krosa-laboratory/analog-pid-buck-controller/Docs/DOC-ANALOG-004.pdf

## DOC-ANALOG-004

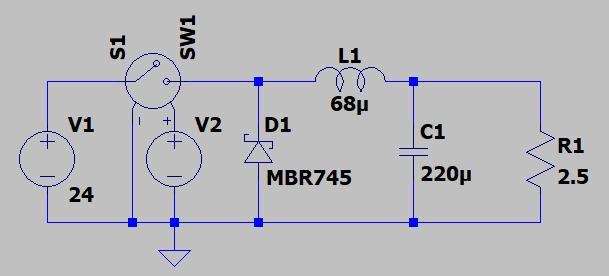
[picture p1: figure]

1 Analysis of the Initial Transient and Settling Time Constant

The observation of current behavior during the first 4–5 ms is a major physical finding that directly validates the quality factor derived in DOC-ANALOG-002.

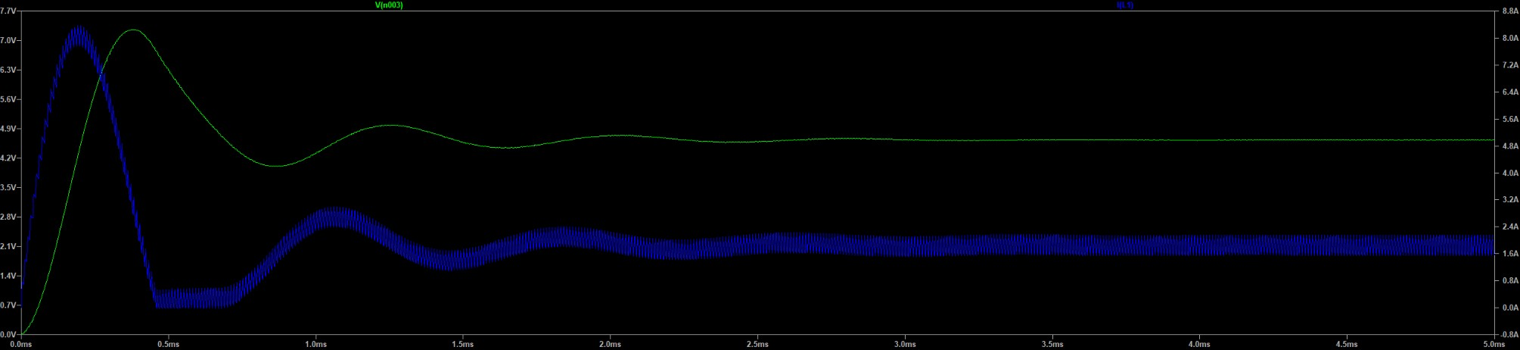
[picture p2: figure]

Figure 1: Vout & IL behavior during initial ms.

The damped sinusoidal envelope observed before reaching steady state is due to the natural response of the underdamped second-order system. The frequency of this transient oscillation corresponds to the damped resonant frequency of the LC filter:

The system's damping time constant (τplant) is determined by the damping coefficient ζ and the natural frequency ω0:

For the transient envelope to decay to 99% of its steady-state value, the system mathematically requires a settling time (ts):

This explains with absolute precision why the current in the coil does not stabilize cleanly until it has passed the 4–5 ms threshold.

2 Quantitative Comparison: Theory vs. Stepped Transient Simulation

Dynamic/Physical Parameter | Theoretical Value (DOC-ANALOG-001) | Actual Measurement in LTspice | Deviation / Error | Technical Conclusion
Peak Current | 2.291 A | 2.150 A | -6.15 % | Lower peak current due to the lower DC output voltage.
Valley Current | 1.709 A | 1.559 A | -8.78 % | Operation fully confirmed in Continuous Driving Mode.
Current Ripple | 0.582 Ap-p | 0.590 Ap-p | +1.37 % | Excellent match. The actual inductive oscillation meets the nominal design specifications.
Output Ripple | ≤ 20.000 mVp-p | 14.739 mVp-p | -26.31 % | It meets the requirement. The 25 mΩ ESR keeps the capacitive noise at 14.74 mV.
Avg. Output Voltage | 5.000 V (Ideal O.Loop) | 4.634 V | -7.32 % | Static voltage drop due to nonlinear losses in the diode.

3 Physical Explanation of the DC Voltage Drop (4.6343 V vs. 5.0000 V)

The measured value of Vout_avg = 4.6343 V, rather than the ideal 5.0000 V, reveals the crucial difference between an ideal model on paper and the physics of a nonlinear switched circuit:

During each switching period Tsw = 10 μs:

- Interval ton = D · Tsw ≈ 2.083 μs (20.83% of the time): The upper switch, S1, is on. Current flows through RDS.on = 10 mΩ and the coil's DCR (rL = 25 mΩ).
- Interval toff = (1 – D) · Tsw ≈ 7.917 μs (79.17% of the time): Switch S1 opens. The current through the coil forces the MBR745 Schottky diode into forward conduction.

The Schottky diode introduces a forward voltage drop Vf ≈ 0.45 V to 0.50 V during nearly 80% of each cycle.

The nominal average voltage at the switching node SW in steady state is given by:

Substituting the circuit values:

Subtracting the additional attenuation caused by the divider consisting of the DCR (rL = 25 mΩ) and the load (RL = 2.5 Ω):

Demonstration of the Need for a Closed-Loop Analog System

This calculation shows that, in open-loop operation, nonlinear drops in semiconductors and parasitic elements degrade static regulation by -7.32%.

This is the purpose of our project: The analog compensator based on op-amps will continuously measure the output voltage Vout, compare it to the stable 5,000 V reference, and dynamically adjust the duty cycle D until the deviation is corrected to exactly 0.000 V of error in steady state.

4 Formal Completion of current Milestone

With the validation of the dynamic signature in small signals (DOC-ANALOG-003) and the confirmation of transient and ripple waveforms in the time domain (DOC-ANALOG-004), the current milestone is officially completed and successfully closed.

5 Start of the Next Milestone: Synthesis of the Type II Compensator

We are now moving on to the design phase of the closed-loop analog controller.

Parámetros de Diseño Fijados para el Compensador Tipo II

- Target Crossing Frequency (fC): 10.0 kHz
- Required Op-Amp Gain at 10 kHz (Av.fc): +7.34 dB
- Required Phase Increase (ϕboost): +48.53º (at 10 kHz)
- Input Resistance (RL): 10.0 kΩ (0.1% tolerance)

Synthesis Equations for the Type II Compensator

To inject the phase boost ϕboost centered exactly at fc = 10.0 kHz, the zero fz1 and the pole fp1 of the op-amp's R-C network must be placed symmetrically around fc:

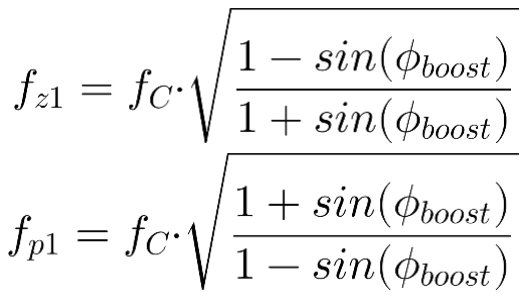
[picture p3: figure]

Substituting phi_boost = 48.53° (sin(48.53°) ≈ 0.7493):

1. Compensator Zero Location: fz1 = 10,000 · 0.3785 ≈ 3.785 kHz
2. Location of the High-Frequency Complex: fp1 = 10,000 / 0.3785 ≈ 26.420 kHz

Equations for Passive Components (R2, C1, C2) With R1 = 10.0 kΩ

1. Calculation of R2:

Since fc is the geometric mean of fz1 and fp1, the root factor simplifies to unity at the crossover frequency:

2. Calculation of C1 (Zero Capacitor):
3. Calculation of C2 (High-Frequency Pole Capacitor):

Selection of Standard Marketable Securities (E96 / E24 at 1% and 5%)

- R1 = 10.0 kΩ (0.1% Metal Film)
- R2 = 23.2 kΩ (0.1% Metal Film)
- C1 = 1.80 nF (Polypropylene Film / C0G)
- C2 = 300 pF (C0G/NP0 Ceramic)

### 6 Summary and Final Selection of the Compensation Network (Type III)

### 6.1 Rationale for Architectural Migration

The small-signal simulation of the open-loop system (LC filter with L=68 uH, C=220 uF, DCR=25 mΩ, ESR=25 mΩ) revealed a critical phase delay in the plant of -158.53° at the target crossover frequency fc = 10 kHz. Combined with the -90° phase delay of the analog integrator at the input, the uncompensated phase drops to -248.53°.

A Type II compensator (limited to a phase shift of less than +60°) is physically incapable of stabilizing the system (resulting in an unstable phase margin of Φm = -21.09°). Consequently, a Type III compensator (2 zeros, 2 poles, and 1 integrator at the origin) is synthesized based on the ADA4610-1 ultra-low bias current JFET op-amp.

### 6.2 Impedance Architecture and Connection Diagram

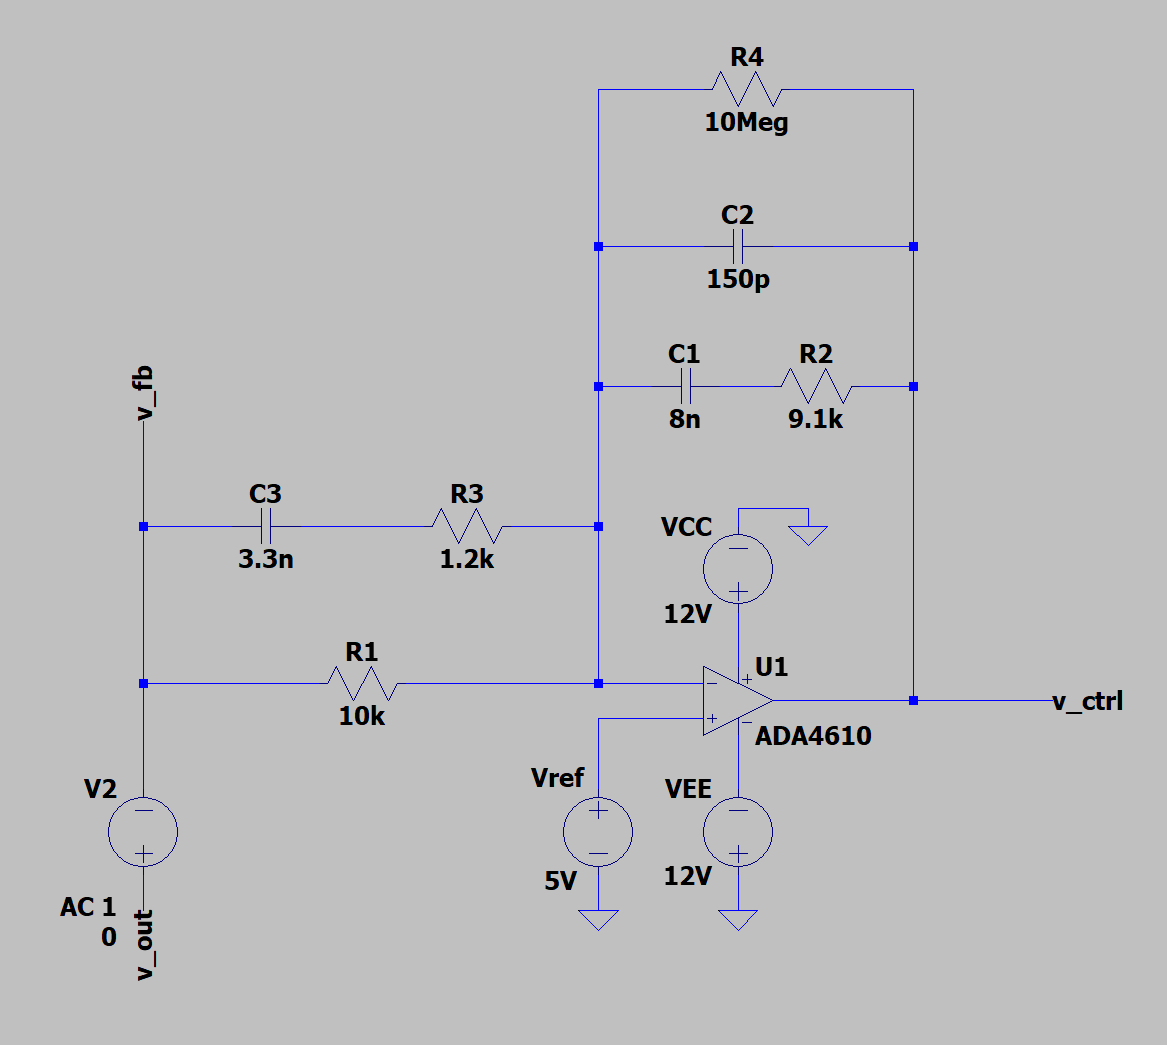
[picture p4: figure]

### 6.3 Complete Transfer Equation Av(s)

The complete transfer function of the Type III compensator is given by:

### 6.4 Physical Location of Zeros and Poles (Frozen BOM Values)

With the list of discrete components adjusted and validated in Ltspice:

- First Zero (fz1): Cancels the voltage drop across the LC dual pole of the power filter.
- Second Zero (fz2): It injects the pre-crossover phase shift.
- First Pole (fp1): Filters high-frequency noise and harmonics from the PWM modulator.

- Second Pole (fp2): Reduces switching noise without compromising phase at 10 kHz.

### 6.5 Frozen Bill of Materials (BOM) — Offset Network

- R1: 10.0 kΩ (0.1% tolerance, metal film, ±25 ppm/°C)
- R2: 9.10 kΩ (0.1% tolerance, metal film, ±25 ppm/°C)
- R3: 1.20 kΩ (0.1% tolerance, metal film, ±25 ppm/°C)
- C1: 8.00 nF (1% tolerancia, Película de Polipropileno / C0G)
- C2: 150.0 pF (1% tolerancia, Cerámico C0G/NP0)
- C3: 3.30 nF (1% tolerance, C0G/NP0 ceramic)
- Rdc: 10.0 MΩ (DC bias in parallel with Zf for SPICE stability)
