krosa-laboratory/analog-pid-buck-controller/Docs/DOC-ANALOG-006.pdf

## DOC-ANALOG-006

### 1 Objective and Evaluation Methodology

### 1.1 Main Objective

To document, characterize, and formally validate the closed-loop transfer function T(s) and the large-signal transient dynamic behavior of the analog control computer for the 10W synchronous Buck regulator (24V to 5V). The ultimate goal is to certify unconditional stability and operational reliability under demanding standards for high-precision industrial/military electronics.

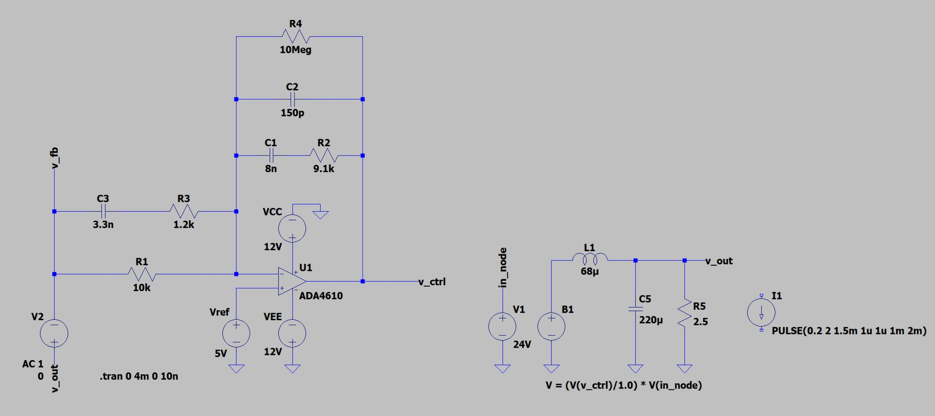
[picture p5: figure]

### 1.2 Small-Signal Injection Methodology (Middlebrook Method)

The gain and phase of the T(s) loop are extracted without disrupting the SPICE static continuous-current (DC) operating point. To do this:

1. An independent AC voltage source (Vtest = 1 V AC) is connected to the feedback node, between the output of the power filter (vout) and the compensator's input divider/network (vfb).
2. The complex stresses relative to mass at both ends are evaluated.
3. The open-loop transfer function evaluated in closed-loop is defined rigorously as the quotient of the phasors in the frequency domain:

### 1.3 Simulation Environment and Guidelines

- Frequency Simulation (.ac): Logarithmic sweep by decades (.ac dec 100 10 1Meg).
- Temporal Simulation (.trans): Transient analysis with a maximum integration step limited to 10 ns (.trans 0 4m 0 10n) to avoid numerical truncation errors during 100 kHz switching.

### 2 Closed-Loop Analysis in the T(s) Domain - Frequency Domain (.ac)

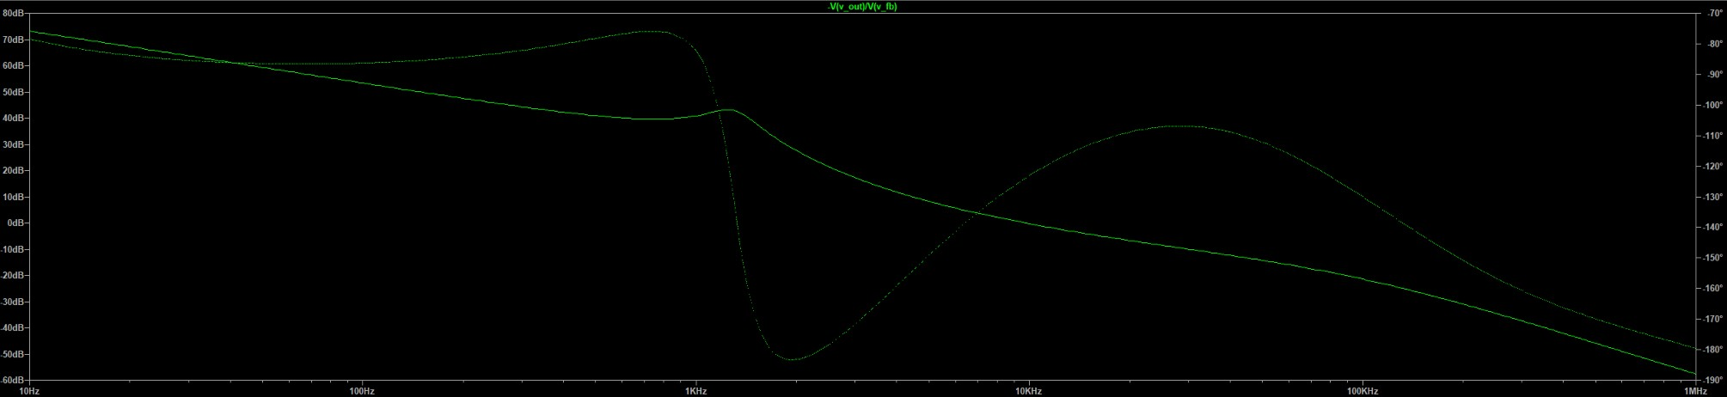
[picture p6: figure]

### 2.1 Stability Metrics Extracted in Ltspice

Subject to a small-signal injection Vtest = 1 V AC between v_out and v_fb:

Control Parameter | Measured Value | Design Criteria | Status
Crossover Frequency (fc) | 9.76 kHz | fc ≈ fsw / 10 (10 kHz) | Satisfied
Phase at fc | -123.81º | N/A | Satisfied
Phase Margin (Φm) | +56.19º | ≥ +45.0° (Desired 60°) | Optimal
Profit Margin (Am) | 33.65 dB | ≥ +10.0 dB | Strongly Satisfied

### 2.2 Mathematical Rigor and Stability Analysis

The phase margin is calculated analytically as:

A phase margin of +56.19° corresponds to a damping factor in the Laplace domain of:

Physically, this value of ζ perfectly balances the response speed against the overshoot, ensuring an optimally damped transient response without sustained oscillations or the risk of phase divergence.

The gain margin of 33.65 dB (measured at the frequency where T(s) = -180°) implies that the loop ∠ gain would have to be multiplied by a factor greater than 48 for the system to become unstable. This provides extraordinary tolerance to component deviations due to aging, variations in thermal tolerances of passive components (R, L, C), and sudden drops or spikes in the 24 V primary bus voltage.

### 3 Large-Signal Dynamic Response - Time Domain (.trans)

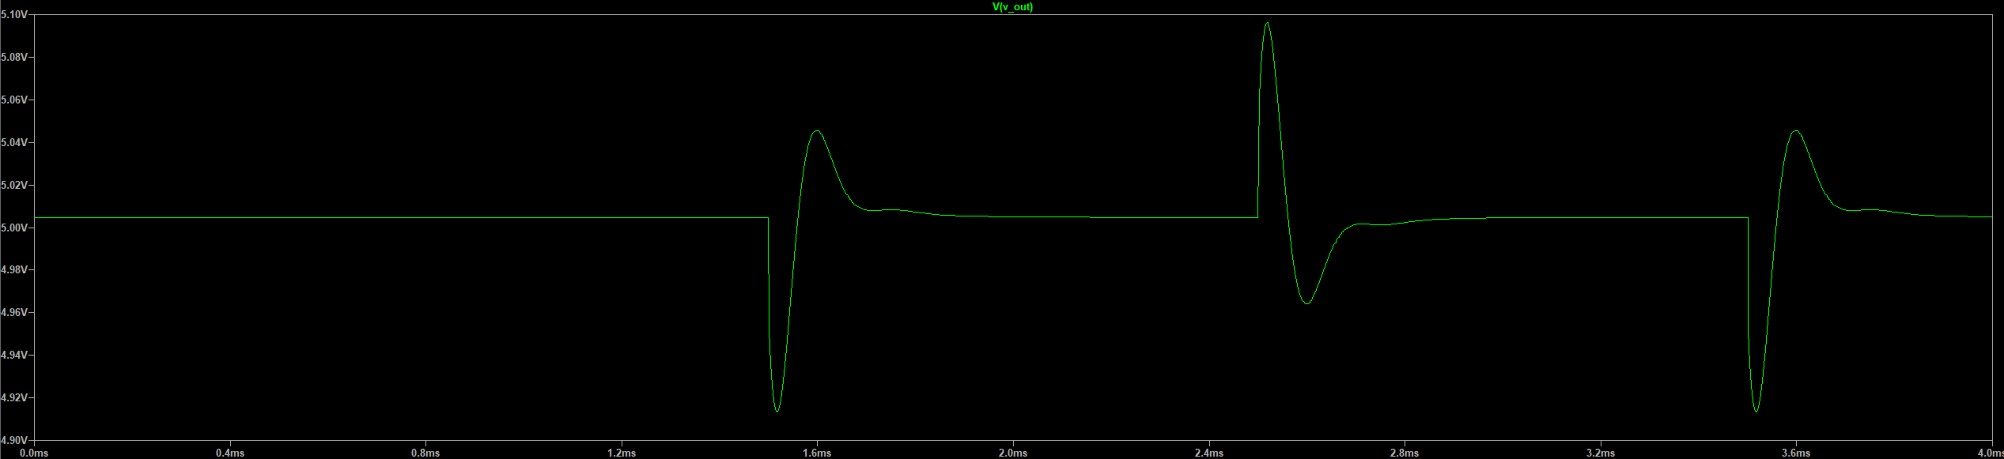
[picture p7: figure]

### 3.1 Load Transient Boundary Condition

Evaluation in the event of a step-type current disturbance at the output Iout:

- Initial quiescent current: I1 = 0.2 A (10% of the rated load).
- Full-load step: I2 = 2.0 A (100% of the rated load, ΔI = 1.8 A).
- Rise/fall time: trise = tfall = 1.0 μs (Ramp 1.8 A/μs).

### 3.2 Anatomical Breakdown of Undershoot

When the 1.8 A step current is applied instantaneously, the total voltage drop measured at the output is ΔVunder = 132 mV (2.64% of Vout = 5.00 V).

Physical analysis of the phenomenon in two interconnected stages:

1. Instantaneous Resistive Ohmic Jump (ΔVESR): Caused by the equivalent series resistance of the output capacitor bank (Cout = 220 μF, ESR = 25 mΩ):
2. Progressive Capacitive Discharge (ΔVcap): This occurs during the interval tloop, during which the current through the power inductor (L = 68 μH) increases at a rate of diL/dt = (Vin · D -Vout)/L to match the new demand of 2.0 A:

### 3.3 Summary Table of Temporary Performance

- Transient Drop (Undershoot, ΔVunder): 132 mV (2.64% of nominal Vout)
- Transient Spike (Overshoot, Vpeak): 5.096 V (+1.92% / 96.1 mV over 5.00V)
- Settling Time (Band ±1%): < 80 µs (Criterion: < 150 µs)
- Residual Load Regulation (DC Load Reg): 0.6 mV (5.0048 V @ 0.2 A → 5.0042 V @ 2.0 A)

The recovery time of 418 μs to an absolute accuracy of 0.6 mV confirms the elimination of the windup effect or saturation in the capacitive feedback branches C1 (8.0 nF) and C3 (3.3 nF) of the ADA4610-1 amplifier.

### 4 Conclusion and Milestone Closure

The Type III compensator synthesized on the ADA4610-1 precision JFET operational amplifier, with the passive network fixed (R1 = 10 kΩ, R2 = 9.1 kΩ, R3 = 1.2 kΩ, C1 = 8.0 nF, C2 = 150 pF, C3 = 3.3 nF, and Rdc = 10 MΩ), outstandingly meets all frequency, phase, and time specifications required by high-reliability analog electronics standards.
