krosa-laboratory/analog-pid-buck-controller/Docs/DOC-ANALOG-007.pdf

## DOC-ANALOG-007

1 Executive Summary and Input Bus Specifications

The actual Issue establishes the primary power conditioning and active protection stage for the Analog Computer for Control Dynamics. The module receives an unregulated supply from a nominal 24 VDC industrial bus and delivers a clean, damped, and surge-protected supply rail (Vbuck_in) to the downstream secondary Buck converter and precision bipolar linear regulators (±15 V).

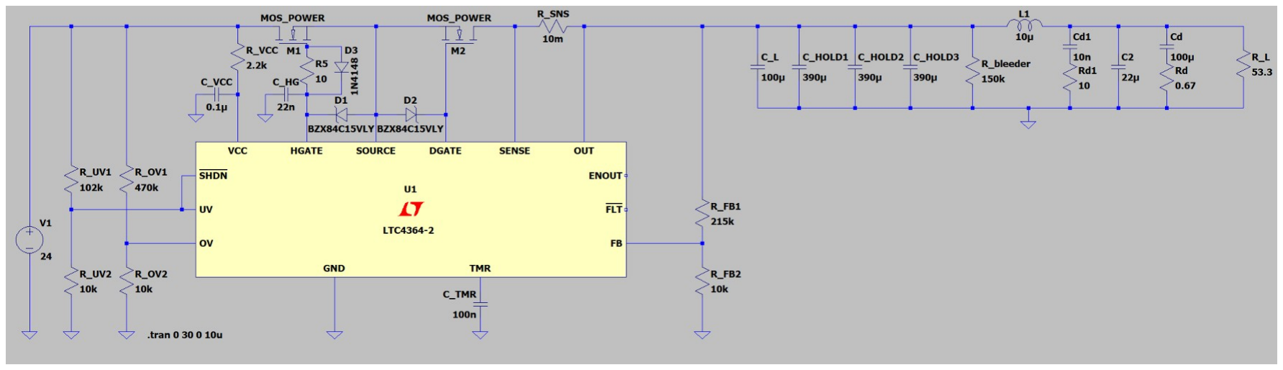
[picture p8: figure]

Physical Operating Requirements

- Nominal Supply Voltage (Vnom): +24 VDC (18 V to 32 V continuous operating window).
- Active Surge Clamping: Clamped to Vclamp = 28.125 V during +80 V input surges (Load Dump transients spanning 15 ms to 100 ms).
- Reverse Polarity Protection: Absolute blocking with zero leakage current under bus collapse down to -30 V.
- Brownout Ride-Through (thold): Minimum hold-up time thold ≥ 13.6 ms above 18 V under brownout to 0 V at 10.8 W nominal load.
- Inrush Current Limitation: Iinrush ≤ 550 mA via a controlled dV/dt Miller ramp into a 1.17 mF capacitor bank.
- Input Loop Stability: Compliance with Middlebrook Stability Criterion (|Zout,filter| « |Rin,buck|).

### 2 Monolithic Active Architecture (LTC4364-2) and Back-to-Back Power Stage

To eliminate forward conduction power losses associated with conventional Schottky diodes (Vf ≈ 0.7 V) and avoid the progressive degradation of Metal Oxide Varistors (MOVs), the design utilizes an LTC4364-2 surge stopper with an integrated ideal diode controller. The pass element comprises two discrete N-Channel power MOSFETs (MOS_POWER) connected in a common-source (backto-back) configuration.

### 2.1 Linear Overvoltage Regulation (M1)

During an input surge (VIN > 28.1 V), the internal voltage amplifier (V A) controls the HGATE pin, modulating M1's gate-to-source voltage VGS to operate the MOSFET in its linear/active region. The feedback divider connected to the FB pin sets the maximum clamped output voltage:

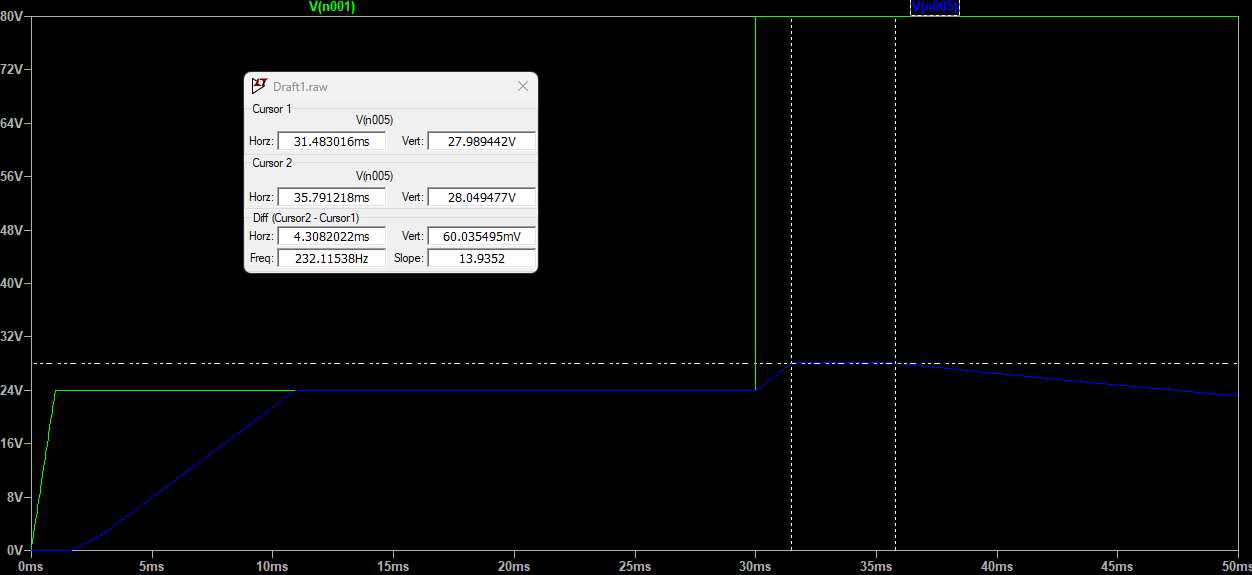
[picture p9: figure]

### 3 Physics of the SOA Fault Timer (CTMR) and Auto-Retry Cooling Dynamics

During the +80 V surge event, transistor M1 drops VDS ≈ 51.9 V across its channel while conducting full load current. To prevent junction temperature TJ from exceeding the Safe Operating Area (SOA) energy limit (P²
t), the LTC4364-2 charges the TMR pin with a current proportional to VCC – VOUT:

For VCC - VOUT = 51.9 V, the pull-up current equals ITMR ≈ 35.1 μA. With CTMR = 100 nF, the maximum allowable linear regulation period before fault trip is:

### 3.1 Auto-Retry Cooling Cycle (LTC4364-2)

When VTMR reaches 1.35 V, M1 turns off and the controller initiates 32 charge/discharge cycles on CTMR between 0.15 V and 1.35 V at 2 μA:

The resulting thermal duty cycle D = 5.5 ms / 3780 ms ≈ 0.145% guarantees complete silicon thermal relaxation prior to auto-retry.

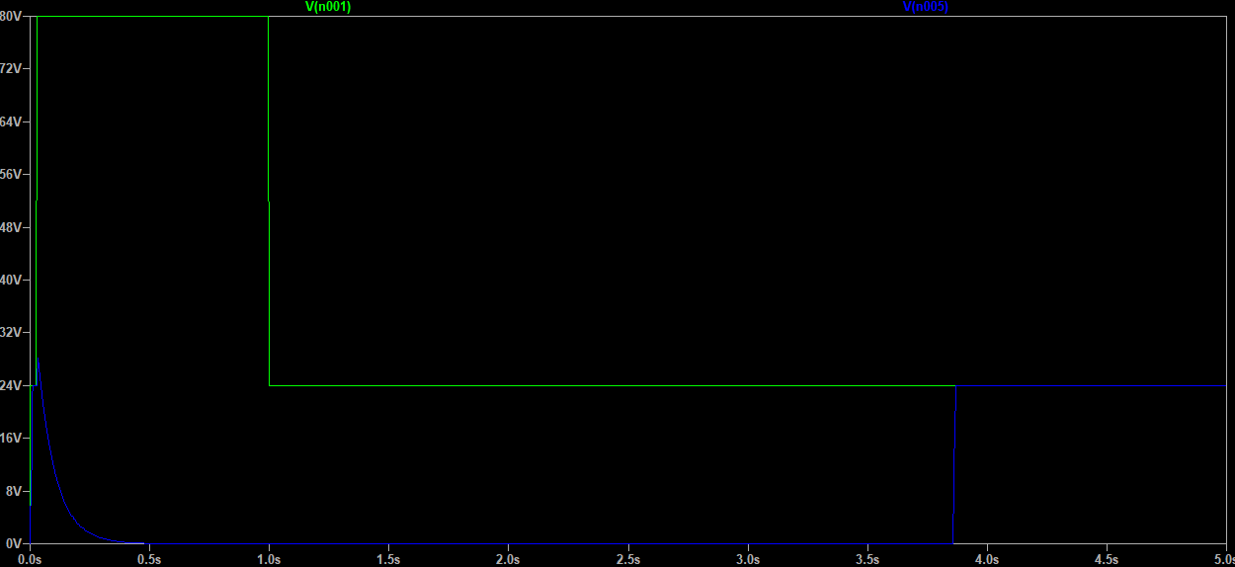
[picture p10: figure]

### 4 Reverse Polarity Protection Dynamics (-30V)

Transistor M2 operates as an ideal diode. The controller monitors the differential forward drop between the common SOURCE node and the SENSE pin (ΔVSD).

- Forward Conduction: The DGATE pin is pumped above SOURCE to regulate a forward drop of ΔVSD = 30 mV across M2, reducing static power dissipation (P = I²
- RDS(on)).
- Reverse Blocking: When VIN collapses to -30 V, current flow reverses. As soon as ΔVSD < -30 mV, an active fast pull-down circuit discharges DGATE to SOURCE with a 130 mA sink current in t < 0.35 μs.

When M2 opens, its intrinsic P-N body diode becomes strongly reverse-biased relative to the load, preventing reverse discharge currents from CHOLD back into the faulted input bus.

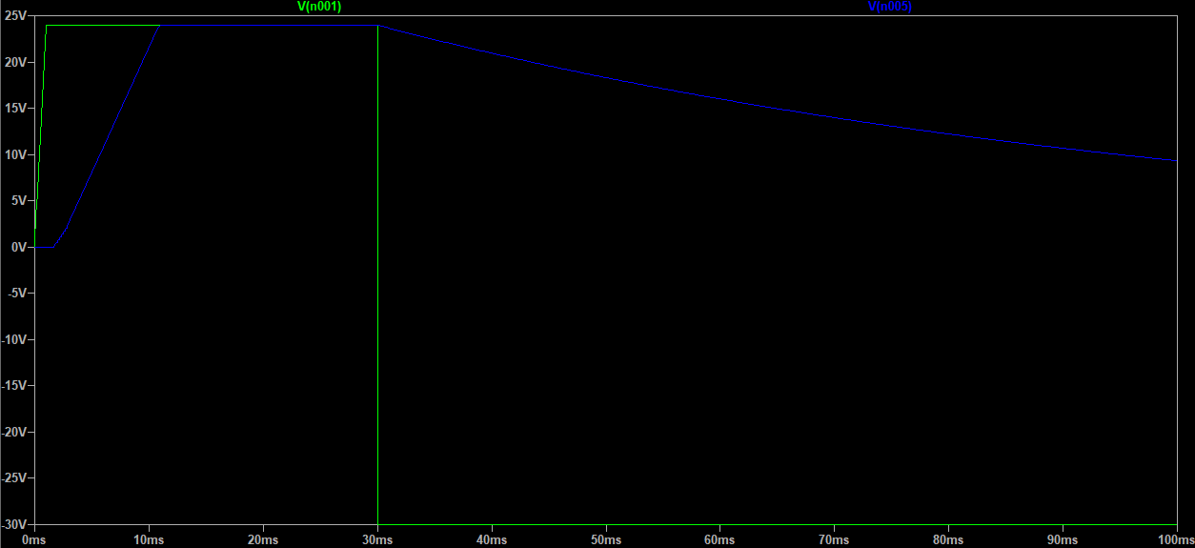
[picture p11: figure]

### 5 Inrush Current Control and Hold-Up Capacitor Bank (CHOLD)

### 5.1 Miller Gate Ramp (CHG)

To prevent destructive inrush current spikes into the 1.17 mF bank during power-up, a Miller capacitor CHG = 22 nF connected to HGATE limits the output voltage slew rate:

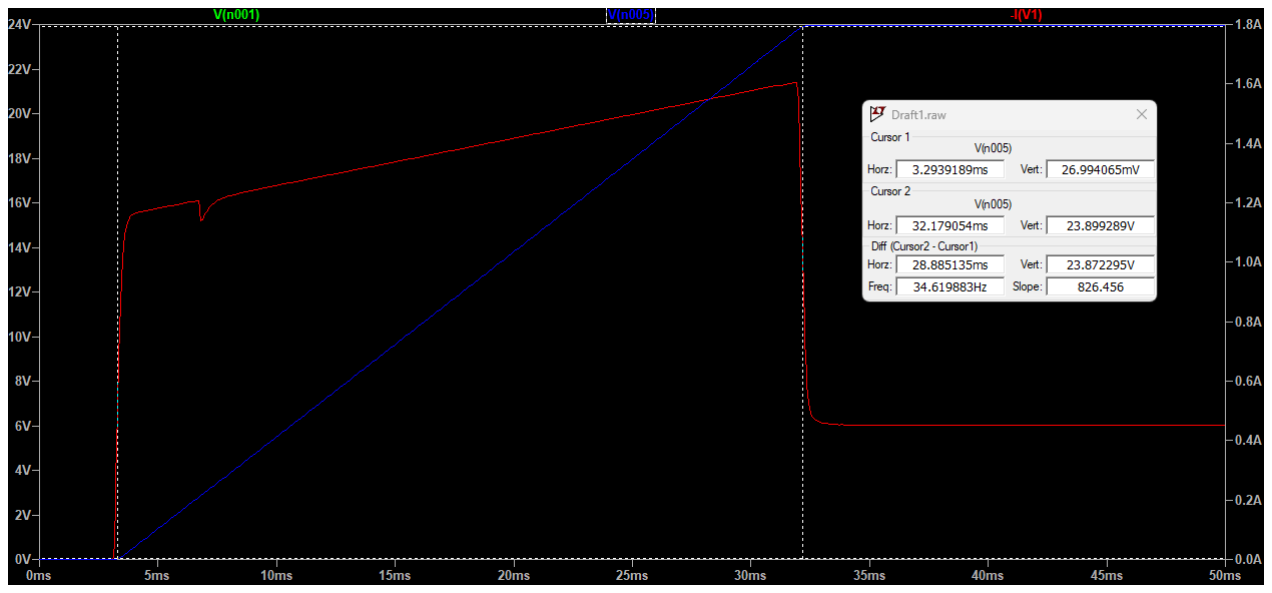
[picture p12: figure]

### 5.2 Hold-Up Capacitance Sizing

During a total input loss (VIN to 0 V), the energy required to support 10.8 W of constant-power load desynchronizes from Vnom = 24 V down to Vmin = 18 V:

The bank is implemented using 3 parallel polymer hybrid aluminum capacitors of 390 μF/35 V (CHOLD,total = 1170 μF, ESR < 7 mΩ).

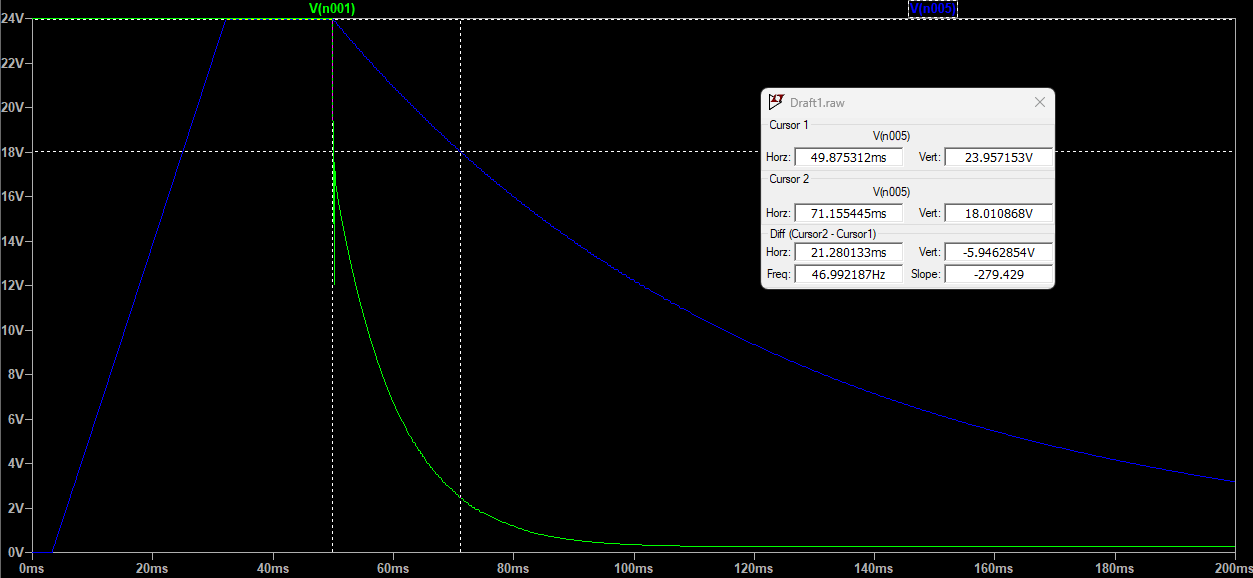
[picture p13: figure]

### 5.3 Safe Passive Discharge (Rbleeder)

A passive bleeder resistor Rbleeder = 150 kΩ is placed in parallel with CHOLD to discharge residual energy upon main system de-energization:

The value of Rbleeder prioritizes efficiency and steady-state PCB thermal stability (Ploss ≈ 3.84 mW), preventing thermal gradients that would induce offset drifts in the precision operational amplifiers of the analog core.

### 6 Gate Oxide Immunity (VGS) and Primary TVS Protection

### 6.1 Gate Oxide Protection Network

1. Zener Clamp Diodes (D1, D2): Two 15 V Zener diodes (BZX84C15VLY) connected across GATE and SOURCE of M1 and M2 prevent high dV/dt transients or capacitive feedthrough from exceeding the absolute gate-oxide breakdown rating (VGS,max = ±20 V).
2. Fast Gate Discharge Diode (D3): A 1N4148W diode is connected in antiparalel across damping resistor R5 = 10 Ω. During short-circuit events, D3 conducts in forward bias, allowing the 130 mA fast pull-down driver to bypass R5 and rapidly discharge input capacitance Ciss.

### 6.2 Primary Input TVS

A unidirectional TVS diode SMAJ70A installed directly at input node N001 clips ESD and submicrosecond inductive surges to below 70 V before the LTC4364-2 active loop responds.

### 7 Output π-Filter and Middlebrook Stability Criterion

The downstream Buck DC-DC stage exhibits a negative incremental input resistance Rin,buck ≈ -53.3 Ω. To prevent relaxation oscillations on the 24 V bus, the output π-filter (L1 - C2) includes a parallel damping network (Cd - Rd).

### 7.1 Middlebrook Damping Equations

1. Critical Damping Capacitance (Cd):
2. Damping Resistance (Rd):

The filter's peak output impedance is clamped to |Zout,filter|max ≈ Rd = 0.67 Ω. Since 0.67 Ω « |-53.3 Ω|, the control loop phase margin of the Buck regulator remains intact (> 38 dB stability margin).

### 7.2 High-Frequency Snubber Decoupling (Csnub – Rsnub)

To absorb high-frequency L1 di/dt inductive spikes without degrading the Middlebrook lowfrequency damping, a parallel snubber branch (Csnub = 10 nF, Rsnub = 10Ω) is added:

- At Filter Resonance (f0 ≈ 10.7 kHz): Snubber impedance |Zsnub| ≈ 1483 Ω » |ZCd-Rd| ≈ 0.686 Ω. Resonance damping current flows exclusively through Cd – Rd.
- At High Frequency (f ≥10 MHz): Equivalent Series Inductance (ESL) blocks Cd, while Csnub acts as a low-impedance path, enabling Rsnub = 10 Ω to disipate di/dt switching spikes.
