krosa-laboratory/analog-pid-buck-controller/Docs/DOC-ANALOG-002.pdf

### DOC-ANALOG-002

1. Formulation of the Physical Model of the Plant with Parasites

To obtain a numerically exact small-signal transfer function from control input to output Gvd(s) it is essential to abandon the assumptions of ideal components. In high-precision analog systems, the DC resistance of the inductor (DCR) and the equivalent series resistance of the output capacitor (ESR) significantly affect the damping factor, DC gain, and the location of the cutoff frequencies.

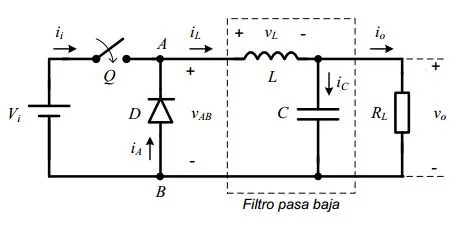
[picture p16: figure]

Nominal System Parameters (CCM Operating Point)

Parasitic Element / Parameter | Symbol | Physical Value | Origin / Physical Criteria
Input Voltage | Vin | 24.0 V | Nominal Power Bus
Load Resistance | RL | 2.5 Ω
Output Inductance | L | 68.0 μH | Rated power inductance
DC Resistance of Inductance | RL (DCR) | 25.0 mΩ | Losses due to copper wires in the winding
Output Capacity | Cout | 220.0 μF | Output Bank Capacity
Equivalent Series Resistance | RC (ESR) | 25.0 mΩ | Losses in the dielectric/terminals of Cout
2. Formal Derivation of the Transfer Function Gvd(s)

Using the state-space averaging method in Continuous Conduction Mode (CCM), the switching node is replaced by an equivalent voltage source with a small-signal average value vsw(s) = Vin · d̂(s).

Step 1: Impedance of the Parasitic Capacitive Block ZC(s)

The impedance of the output capacitor branch with its ESR in series is:

Step 2: Equivalent Load Impedance ZP(s)

By connecting the capacitive branch ZC(s) in parallel with the load resistor RL:

Step 3: Voltage Divider Used in the Plant

The output voltage v̂ out(s) is obtained using the voltage divider between ZP(s) and the series inductive branch (sL + rL):

Substituting the expression for ZP(s):

By multiplying the numerator and denominator by [1 + sCout (RL + rC)]:

Expanding the terms in the denominator D(s):

Grouping
terms by powers of the complex variable s:

Factoring (RL + rL) to obtain the normalized canonical polynomial form:

### 3. Second-Order Canonical Form and Numerical Analysis

Expressing Gvd(s) in its standard canonical representation in control theory:

### 3.1. Direct Current Gain Gvd0(s)

Due to the voltage drop attenuated by the resistive divider consisting of the DCR (rL) and the load (RL):

On a

logarithmic magnitude scale:

### 3.2. Zero Introduced by the Capacitor's ESR (wz, fz)

The output capacitor's ESR (rC) introduces a real zero in the left half-plane that stops the gain rolloff at high frequencies and injects a phase lead of +90º:

### 3.3. Resonant Frequency of the Double Pole (w0, f0)

The quadratic term in the denominator defines the natural resonance frequency of the damped LC filter:

Substituting the values from the system:

- Numerator: RL + rL = 2.5 + 0.025 = 2.525 Ω
- Denominator: LCout(RL + rC) = (68 x 10⁻⁶) · (220 x 10⁻⁶) · (2.5 + 0.025) = 1.496 x 10⁻⁸ · 2.525 = 3.7774 x 10⁻⁸ s²
- Ω

Calculating the fundamental frequency in Hertz (Hz):

### 3.4. Resonant Quality Factor (Q) and Damping (ζ)

The coefficient of the linear term s in the denominator satisfies the relation 1 / Qw0 = b1:

Evaluating the combined parasitic terms:

- RLrC = 2.5 · 0.025 = 0.0625 Ω
2
- rLRL = 0.025 · 2.5 = 0.0625 Ω
2
- rLrC = 0.025 · 0.025 = 0.000625 Ω
2
- Sum of Terms Rcomb = 0.125625 Ω
2

Numerator of b1:

Dividing by (RL + rL) = 2.525 Ω:

Therefore, the Quality Factor Q is:

The dimensionless damping factor ζ is given by:

Interpretation of Resonant Overdrive (Peaking)

Since Q = 3.230 > 0.707, the system exhibits severe underdamping near f0 = 1.301 kHz. The peak magnitude relative to the DC gain is:

### 4. Summary Table of Plant Dynamics (Open-Loop)

Dynamic Parameter | Notation | Calculated Exact Value | Physical and Circuit Analysis
Gain in DC | Gvd0 | 23.762 V (27.52 dB) | Mitigated by DCR (rL = 25 mΩ)
LC Resonant Frequency | f0 | 1,31.23 Hz (1.301 kHz) | Location of the filter's dual pole
Magnitude Resonance Peak | |Gvd(f0)|max | +37.70 dB (+10.18 dB vs DC) | Characteristic underdamping (ζ = 0.155)
Resonant Phase Drop | ∕Gvd(f0) | -90º (abrupt transition to -180º) | Requires compensation by adv. network
Zero per ESR of Cout | fz | 28,952.42 Hz (28.95 kHz) | Flatten the slope of -40 to -20 dB/dec

### 5. Physical Implications for the Design of Type II/III Compensators

- Severe Phase Delay: Between 1.0 kHz and 2.0 kHz, the phase collapses from 0º to nearly -180º. If the desired crossover frequency (fc) is set to 10 kHz (fsw / 10), the analog compensator must provide a phase boost of approximately +70º to +80º using zeros located below fc.
- Impact of the ESR (rC): The zero at fz ≈ 28.95 kHz helps restore +90º of phase above 29 kHz. However, in modern polymer capacitors with ESR < 10 mΩ, this zero shifts to much higher frequencies (>75 kHz), forcing the op-amp-based compensator to autonomously provide all compensation using a Type III topology (two zeros and two poles).

### 6. References and Sources of Contrast

For analytical verification, formal derivation of the state space, and comparison of the models with parasitic impedances (DCR and ESR) developed in this document, the following sources of technical reference literature are cited:

1. Middlebrook, R. D., & Ćuk, S. (1976). A General Unified Approach to Modeling Switching-Converter Power Stages. IEEE Power Electronics Specialists Conference (PESC), 18–34. (A seminal work on the state-space averaging technique used in Section 2 to linearize the plant for small-signal analysis.)
2. Vorperian, V. (1990). Simplified analysis of PWM converters using a model of the PWM switch. Part I: Continuous conduction mode. IEEE Transactions on Aerospace and Electronic Systems, 26(3), 490–496.
(Theoretical basis for the equivalent averaged switch model in CCM used in open-loop analytical simulations).
3. Erickson, R. W., & Maksimović, D. (2001). Fundamentals of Power Electronics (2nd ed.). Springer Science & Business Media.
(Chapter 7: Small-Signal AC Modeling; Chapter 8: Converter Transfer Functions. Direct source for the canonical derivation of Gvd(s), damping ζ, and the calculation of the Q factor).

4. Basso, C. (2016). Linear Circuit Transfer Functions: An Introduction to Fast Analytical Techniques (1st ed.). Wiley-IEEE Press.
(Section on the Fast Analytical Techniques [FACTs] method applied to second-order LC filters with parasitic resistances rL and rC, used to determine the zero fz and the operating point offset Gvd0).
5. Ridley, R. (2012). Switching Power Supply Design: Control Loop Cookbook. Ridley Engineering Inc.
(Chapter 2: Small-Signal Modeling of Buck Converters. Comparison Guide for the Impact of Capacitive ESR on the Phase Margin Before Compensation).
6. Texas Instruments / Unitrode. (1999). SLUP113: Modeling, Analysis, and Compensation of DC/DC Converters (Application Note by Karl H. Kruse). Texas Instruments Literature. (Mathematical demonstration of phase collapse at -180º at the f0 resonance and formulation of the frequency response of the power stage).
7. Analog Devices. (2008). AN-1138: High-Speed Op-Amp Compensation and Small-Signal AC Loop Stability. Analog Devices Application Note.
(Analysis methodology for calculating pole interaction between the power stage and the input of the error op-amp).
