krosa-laboratory/analog-pid-buck-controller/Docs/Spice/SIM-ANALOG-009/SIM-ANALOG-009.asc

C_boost: cap; 0.1µ
C_in1: cap; 22µ
C_in2: cap; 0.1µ
C_ith: cap; 10n
C_ithp: cap; 220p
C_out1: cap; 13.2µ; Rser=3m
C_out2: cap; 13.2µ; Rser=3m
C_set: cap; 2.2n
C_vcc: cap; 2.2µ
I1: current; PULSE(0.1 0.6 5m 1u 1u 1m 2m)
L1: ind; 15µ; Rser=45m
R_ith: res; 2.2k
R_L: res; 30
R_set: res; 360k
RT: res; 100k
U1: LTC7149
Vin: voltage; 24V
Named nets: 0, v_neg_out
.tran 0 7m 0 20n startup
