krosa-laboratory/analog-pid-buck-controller/Docs/Spice/SIM-ANALOG-008/SIM-ANALOG-008.asc

C1: cap; 4.7µ
C2: cap; 2.2n
C3: cap; 1µ
C4: cap; 0.1µ
C5: cap; 13.2µ; Rser=3m
C6: cap; 13.2µ; Rser=3m
C7: cap; 10µ; Rser=3m
C8: cap; 47µ; Rser=150m
C9: cap; 90p; Rser=1m
I1: current; PULSE(0.1 0.6 2m 1u 1u 0.5m 2m)
L1: ind; 10µ; Rser=45m
L2: ind; 2.2µ; Rser=15m
R1: res; 90.9k
R_bot: res; 10k
R_L: res; 30
R_top: res; 175.6k
U1: LT8610
v_buck_in: voltage; 24V
Named nets: 0, v_buck_out, v_ldo_in
.tran 0 3.5m 0 20n startup
