krosa-laboratory/analog-pid-buck-controller/Docs/Spice/SIM-ANALOG-006/SIM-ANALOG-006.asc

B1: bv; V = (V(v_ctrl)/1.0) * V(in_node)
C1: cap; 8n
C2: cap; 150p
C3: cap; 3.3n; Rser=25m
C5: cap; 220µ; Rser=25m
I1: current; PULSE(0.2 2 1.5m 1u 1u 1m 2m)
L1: ind; 68µ; Rser=25m
R1: res; 10k; tol=0.1
R2: res; 9.1k
R3: res; 1.2k
R4: res; 10Meg
R5: res; 2.5
U1: ADA4610
V1: voltage; 24V
V2: voltage; 0; AC 1
VCC: voltage; 12V
VEE: voltage; 12V
Vref: voltage; 5V
Named nets: 0, v_ctrl, in_node, v_out, v_fb
.tran 0 4m 0 10n
