krosa-laboratory/analog-pid-buck-controller/Docs/Spice/SIM-ANALOG-007/SIM-ANALOG-007.asc

C2: cap; 22µ
C_HG: cap; 22n
C_HOLD1: cap; 390µ; Rser=7m
C_HOLD2: cap; 390µ; Rser=7m
C_HOLD3: cap; 390µ; Rser=7m
C_L: cap; 100µ
C_TMR: cap; 100n
C_VCC: cap; 0.1µ
Cd1: cap; 10n
Cd: cap; 100µ
D1: zener; BZX84C15VLY
D2: zener; BZX84C15VLY
D3: diode; 1N4148
L1: ind; 10µ; Rser=15m
M1: nmos; MOS_POWER
M2: nmos; MOS_POWER
R5: res; 10
R_bleeder: res; 150k; tol=1 pwr=0.25
R_FB1: res; 215k
R_FB2: res; 10k
R_L: res; 53.3
R_OV1: res; 470k
R_OV2: res; 10k
R_SNS: res; 10m
R_UV1: res; 102k
R_UV2: res; 10k
R_VCC: res; 2.2k
Rd1: res; 10
Rd: res; 0.67
U1: LTC4364-2
V1: voltage; 24
Named nets: 0
.SUBCKT MOS_POWER D G S
M_CORE D G S S L1_NMOS
D_BODY S D D_FWD
.model L1_NMOS NMOS(Vto=2.5 Kp=80)
.model D_FWD D(Is=10p BV=100 Cjo=2n)
.ENDS
.tran 0 30 0 10u
