krosa-laboratory/analog-pid-buck-controller/Docs/Spice/SIM-ANALOG-004/SIM-ANALOG-004.asc

C1: cap; 220µ; Rser=25m
D1: schottky; MBR745
L1: ind; 68µ; Rser=25m
R1: res; 2.5
S1: sw; SW1
V1: voltage; 24
V2: voltage; PULSE(0 10 0 20n 20n 2.0833u 10u)
Named nets: 0
.tran 0 8m 5m 1n
.model SW1 SW(Vt=5V Vh=0.5V Ron=10m Roff=1Meg)
