krosa-laboratory/analog-pid-buck-controller/Docs/Spice/SIM-ANALOG-003/SIM-ANALOG-003.asc

B1: bv; V=0.20833 * V(in_node) + 24 * V(duty_ac)
C1: cap; 220µ; Rser=25m
L1: ind; 68µ; Rser=25m
R1: res; 2.5
V1: voltage; 24
V2: voltage; ""; AC 1
Named nets: 0, in_node, duty_ac
.ac dec 100 10 1Meg
