krosa-laboratory/analog-pid-buck-controller/(commit log)

2026-10-25 Add analog buck converter simulation docs
    Add the SIM-ANALOG-004 LTspice schematic and simulation outputs alongside its PDF documentation.
2026-10-29 Add LTspice PID buck controller simulation
    Add a transient simulation schematic for the analog PID controller and buck converter, including the compensation network, load, and feedback path.
2026-11-02 Add LTC4364-2 design documentation
    Add DOC-ANALOG-006 and DOC-ANALOG-007 with a new SIM-ANALOG-007 protection circuit, update DOC-ANALOG-004, and reposition the transient command in SIM-ANALOG-006.
2026-11-06 Add LT8610 buck transient simulation
    Add an LTspice schematic modeling a 24 V LT8610 buck converter, its output filtering, and a pulsed load on the downstream LDO input.
2026-11-06 Add LTC7149 negative-output simulation
    Add an LTspice schematic for a 24 V-input LTC7149 converter with a negative output, component values, and a transient pulsed-load simulation.
